Kybernetika-SPSE/DMP_Fiala/ročníkovka vol.2.kicad_pcb

## KiCad design ročníkovka vol.2.kicad_pcb (2025-01-09)

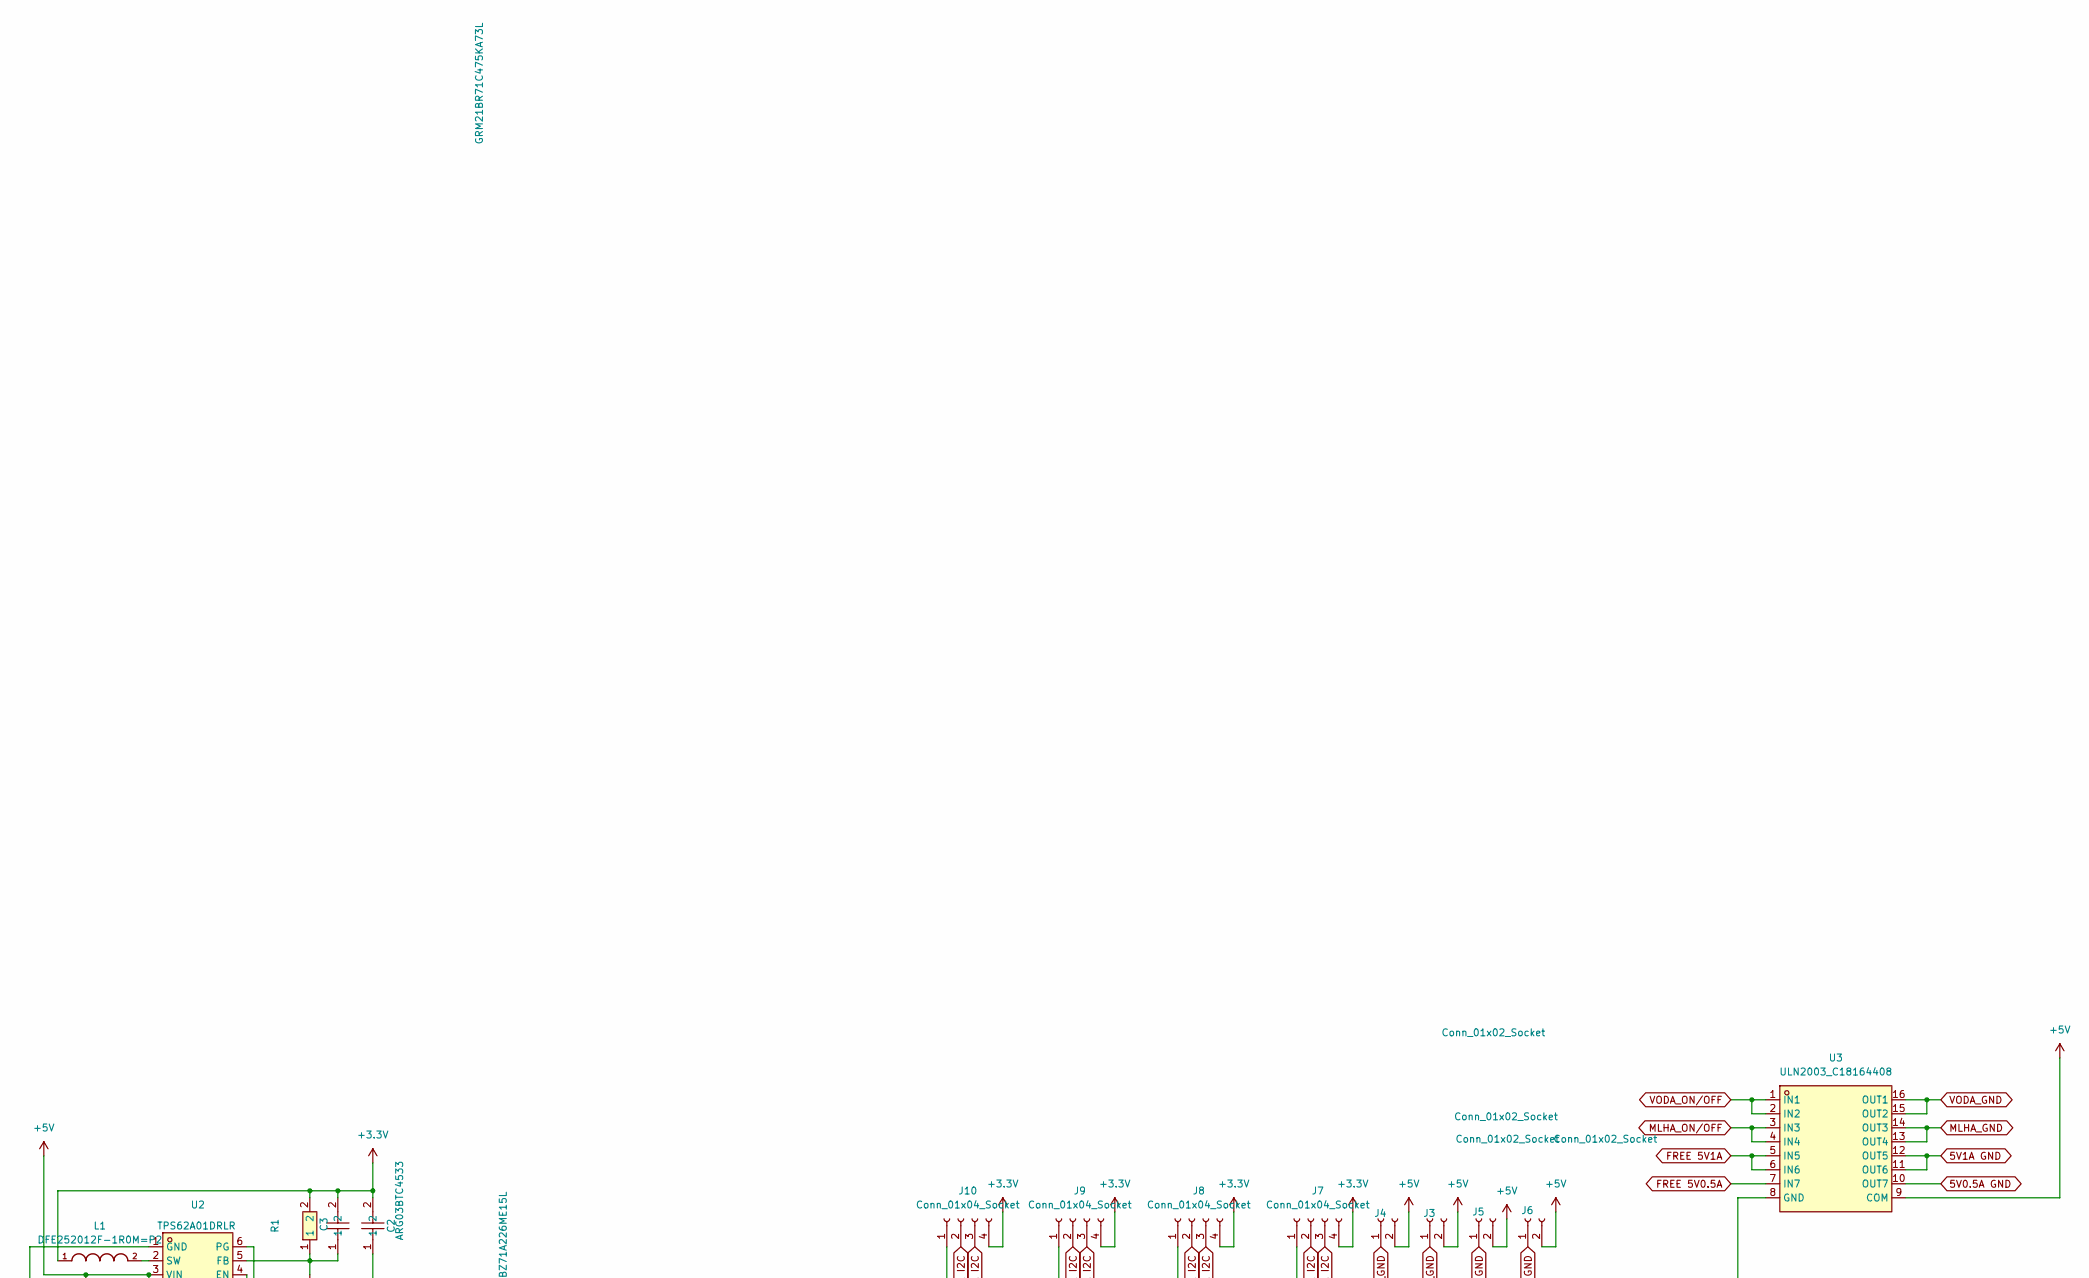
[picture p2: schematic ročníkovka vol.2.kicad_sch, part in row 1, column 1]

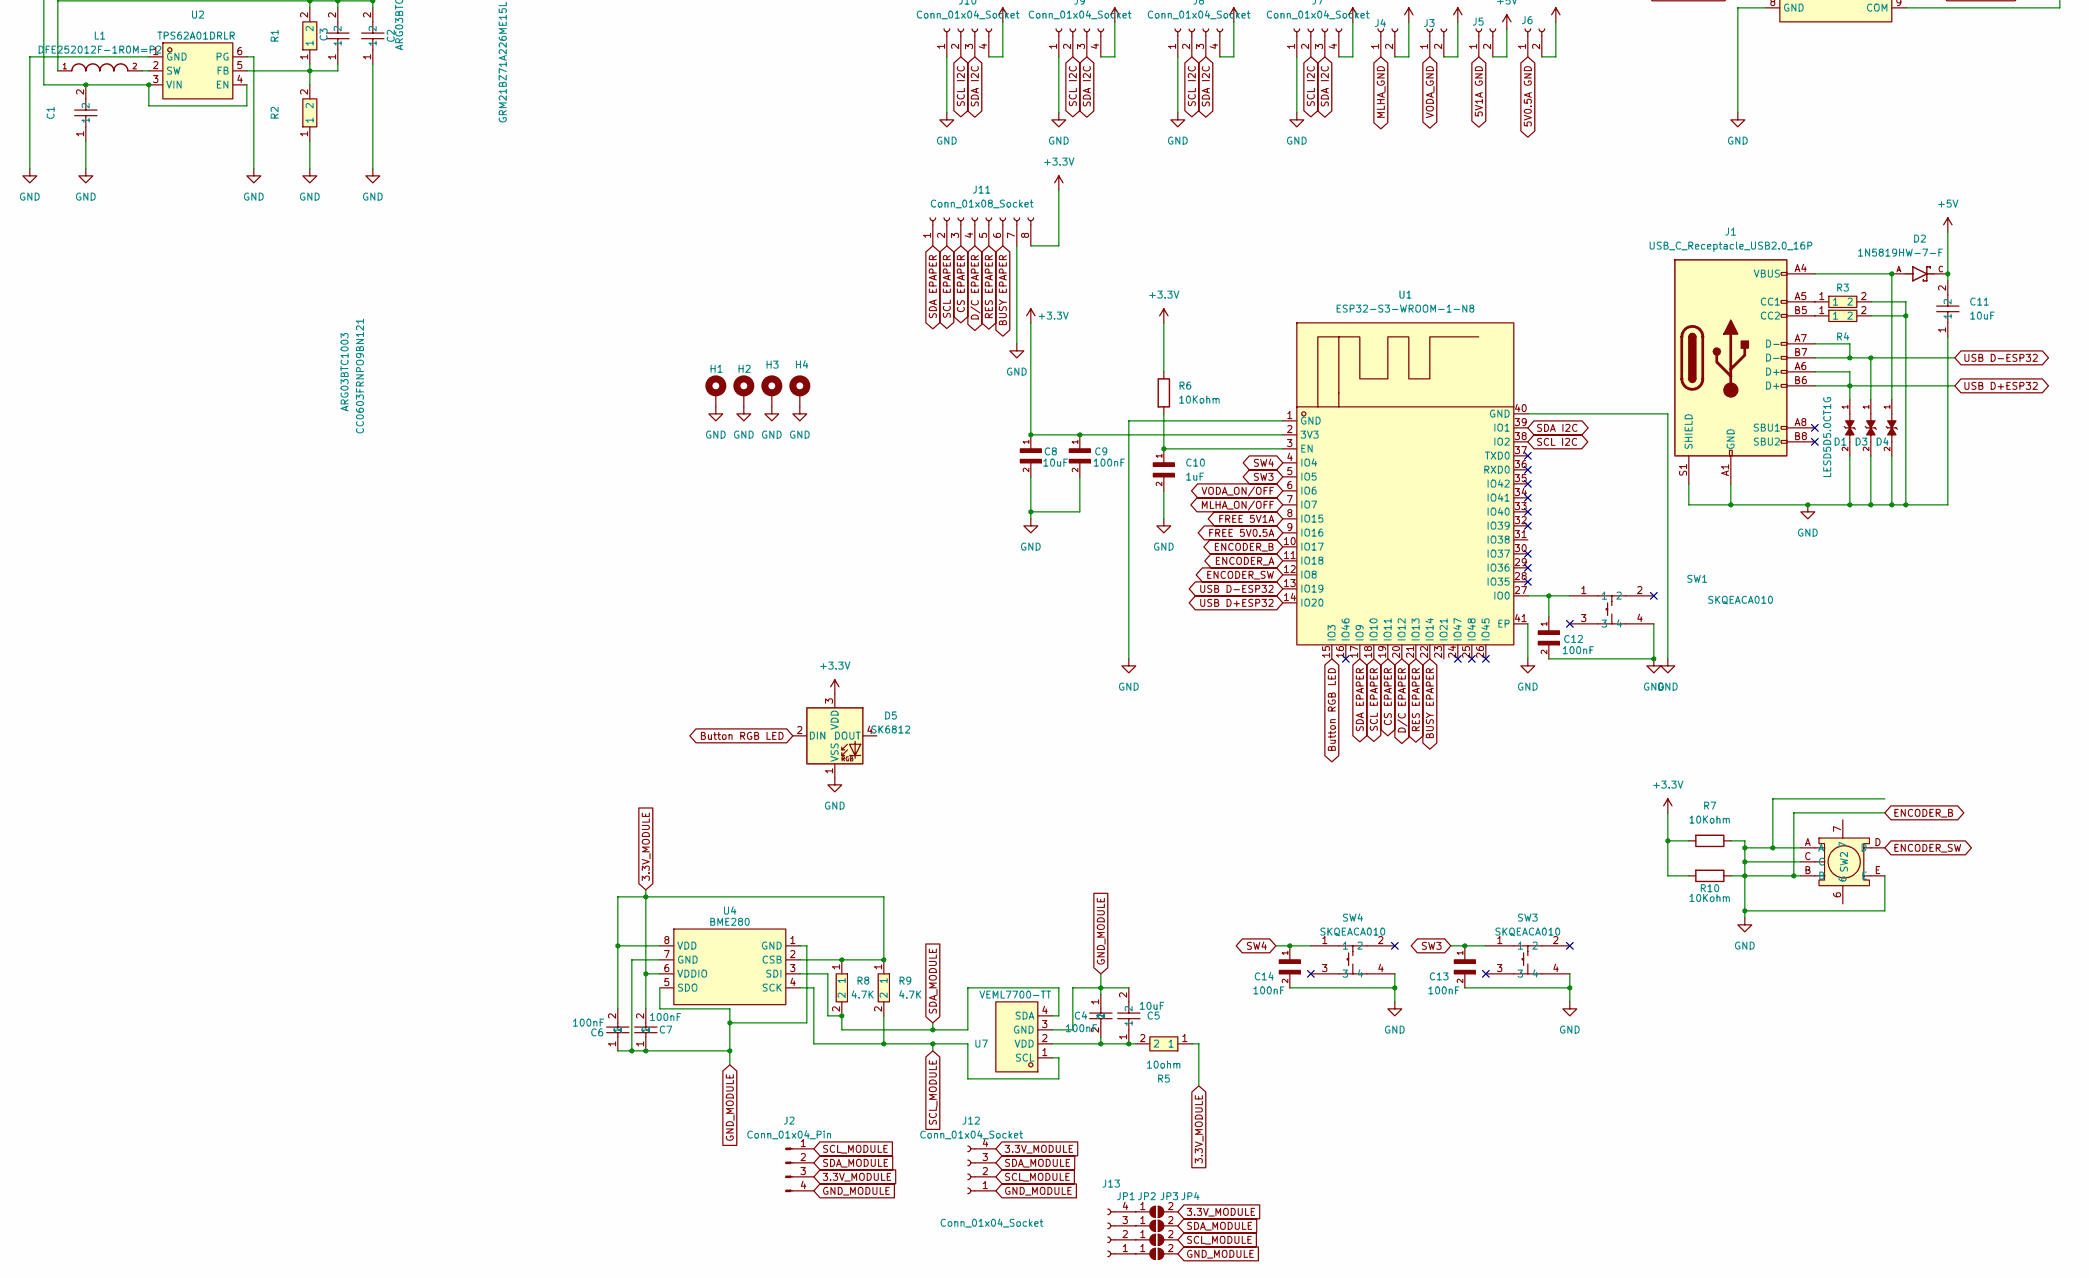
[picture p3: schematic ročníkovka vol.2.kicad_sch, part in row 2, column 1]

Parts:
C1: GRM21BR71C475KA73L; C0805; LCSC Part C86040
C2: GRM21BZ71A226ME15L; C0805; LCSC Part C907991
C3: CC0603FRNPO9BN121; C0603; LCSC Part C519498
C4, C6, C7: 100nF; C0603; LCSC Part C24452
C5: 10uF; C0603; LCSC Part C962136
C8: 10uF; CAPC1608X90N
C9, C12, C13, C14: 100nF; CAPC1608X90N
C10: 1uF; CAPC1608X90N
C11: 10uF; C0603; LCSC Part C96446
D1, D3, D4: LESD5D5.0CT1G; TVS_LESD5D5.0CT1G; PARTREV O
D2: 1N5819HW-7-F; SOD3715X145N; PARTREV 18-2
D5: SK6812; LED_SK6812_PLCC4_5.0x5.0mm_P3.2mm
H1, H2, H3, H4: MountingHole_Pad; MountingHole_3.2mm_M3_Pad_TopBottom
J1: USB_C_Receptacle_USB2.0_16P; USB_C_Receptacle_GCT_USB4105-xx-A_16P_TopMnt_Horizontal; LCSC Part C2988369
J2: Conn_01x04_Pin; JST_PH_B4B-PH-K_1x04_P2.00mm_Vertical
J3, J4, J5, J6: Conn_01x02_Socket; JST_PH_S2B-PH-K_1x02_P2.00mm_Horizontal
J7, J8, J9, J10, J12, J13: Conn_01x04_Socket; JST_PH_S4B-PH-K_1x04_P2.00mm_Horizontal
J11: Conn_01x08_Socket; JST_PH_S8B-PH-K_1x08_P2.00mm_Horizontal
JP1, JP2, JP3, JP4: SolderJumper_2_Open; SolderJumper-2_P1.3mm_Open_TrianglePad1.0x1.5mm
L1: DFE252012F-1R0M=P2; INDC2520X120N
R1: ARG03BTC4533; R0603; LCSC Part C2686428
R2: ARG03BTC1003; R0603; LCSC Part C335088
R3, R4: 0603WAF5101T5E; R0603; LCSC Part C23186
R5: 10ohm; R0603; LCSC Part C414987
R6, R7, R10: 10Kohm; RESC1608X55N
R8, R9: 4.7K; R0603; LCSC Part C99782
SW1, SW3, SW4: SKQEACA010; KEY-TH_4P-L12.0-W12.0-P5.0-LS12.5-EH; LCSC Part C107236
SW2: EC11E15244G1; SW-TH_EC11E15244G1; LCSC Part C370970
U1: ESP32-S3-WROOM-1-N8; WIFIM-SMD_ESP32-S3-WROOM-1-N8; LCSC Part C2913198
U2: TPS62A01DRLR; SOT-5X3-6_L1.6-W1.2-P0.50-LS1.6-BR; LCSC Part C5157937
U3: ULN2003_C18164408; SOP-16_L9.9-W3.9-P1.27-LS6.0-BL; LCSC Part C18164408
U4: BME280; PSON65P250X250X100-8N; LCSC Part C92489
U7: VEML7700-TT; SENSOR-SMD_EML7700-TT; LCSC Part C1850416

Connections:
3.3V_MODULE: C6.2, C7.2, J2.3, J12.4, JP1.2 (B), R5.1, R8.1, R9.1, U4.2 (CSB), U4.6 (VDDIO), U4.8 (VDD)
5V0.5A GND: J6.1, U3.10 (OUT7)
5V1A GND: J5.1, U3.11 (OUT6), U3.12 (OUT5)
+3.3V: C2.2, C3.2, C8.1, C9.1, D5.3 (VDD), J7.4, J8.4, J9.4, J10.4, J11.8, L1.1, R1.2, R6.1, R7.2, R10.2, U1.2 (3V3)
+5V: C1.2, C11.2, D2.C, J3.2, J4.2, J5.2, J6.2, U2.3 (VIN), U2.4 (EN), U3.9 (COM)
BUSY EPAPER: J11.6, U1.22 (IO14)
Button RGB LED: D5.2 (DIN), U1.15 (IO3)
CS EPAPER: J11.3, U1.19 (IO11)
D/C EPAPER: J11.4, U1.20 (IO12)
ENCODER_A: U1.11 (IO18)
ENCODER_B: C1.1, C2.1, C8.2, C9.2, C10.2, C11.1, C12.2, C13.2, C14.2, D1.2, D3.2, D4.2, D5.1 (VSS), H1.1, H2.1, H3.1, H4.1, J1.A1 (GND), J1.A12 (GND), J1.B1 (GND), J1.B12 (GND), J1.S1 (SHIELD), J7.1, J8.1, J9.1, J10.1, J11.7, R2.1, R3.2, R4.2, R7.1, R10.1, SW1.4, SW2.A, SW2.B, SW2.C, SW2.E, SW3.4, SW4.4, U1.1 (GND), U1.10 (IO17), U1.40 (GND), U1.41 (EP), U2.1 (GND), U2.6 (PG), U3.8 (GND)
ENCODER_SW: SW2.D, U1.12 (IO8)
FREE 5V0.5A: U1.9 (IO16), U3.7 (IN7)
FREE 5V1A: U1.8 (IO15), U3.5 (IN5), U3.6 (IN6)
GND_MODULE: C4.1, C5.2, C6.1, C7.1, J2.4, J12.1, JP4.2 (B), U4.1 (GND), U4.5 (SDO), U4.7 (GND), U7.3 (GND)
MLHA_GND: J4.1, U3.13 (OUT4), U3.14 (OUT3)
MLHA_ON/OFF: U1.7 (IO7), U3.3 (IN3), U3.4 (IN4)
unnamed: D2.A, D4.1, J1.A4 (VBUS), J1.A9 (VBUS), J1.B4 (VBUS), J1.B9 (VBUS)
unnamed: J1.A5 (CC1), R3.1
unnamed: J1.B5 (CC2), R4.1
unnamed: J13.1, JP4.1 (A)
unnamed: J13.2, JP3.1 (A)
unnamed: J13.3, JP2.1 (A)
unnamed: J13.4, JP1.1 (A)
unnamed: C10.1, R6.2, U1.3 (EN)
unnamed: C12.1, SW1.1, U1.27 (IO0)
unnamed: C3.1, R1.1, R2.2, U2.5 (FB)
unnamed: L1.2, U2.2 (SW)
unnamed: C4.2, C5.1, R5.2, U7.2 (VDD)
RES EPAPER: J11.5, U1.21 (IO13)
SCL EPAPER: J11.2, U1.18 (IO10)
SCL I2C: J7.2, J8.2, J9.2, J10.2, U1.38 (IO2)
SCL_MODULE: J2.1, J12.2, JP3.2 (B), R9.2, U4.4 (SCK), U7.1 (SCL)
SDA EPAPER: J11.1, U1.17 (IO9)
SDA I2C: J7.3, J8.3, J9.3, J10.3, U1.39 (IO1)
SDA_MODULE: J2.2, J12.3, JP2.2 (B), R8.2, U4.3 (SDI), U7.4 (SDA)
SW3: C13.1, SW3.1, U1.5 (IO5)
SW4: C14.1, SW4.1, U1.4 (IO4)
USB D+ESP32: D1.1, J1.A6 (D+), J1.B6 (D+), U1.14 (IO20)
USB D-ESP32: D3.1, J1.A7 (D-), J1.B7 (D-), U1.13 (IO19)
VODA_GND: J3.1, U3.15 (OUT2), U3.16 (OUT1)
VODA_ON/OFF: U1.6 (IO6), U3.1 (IN1), U3.2 (IN2)

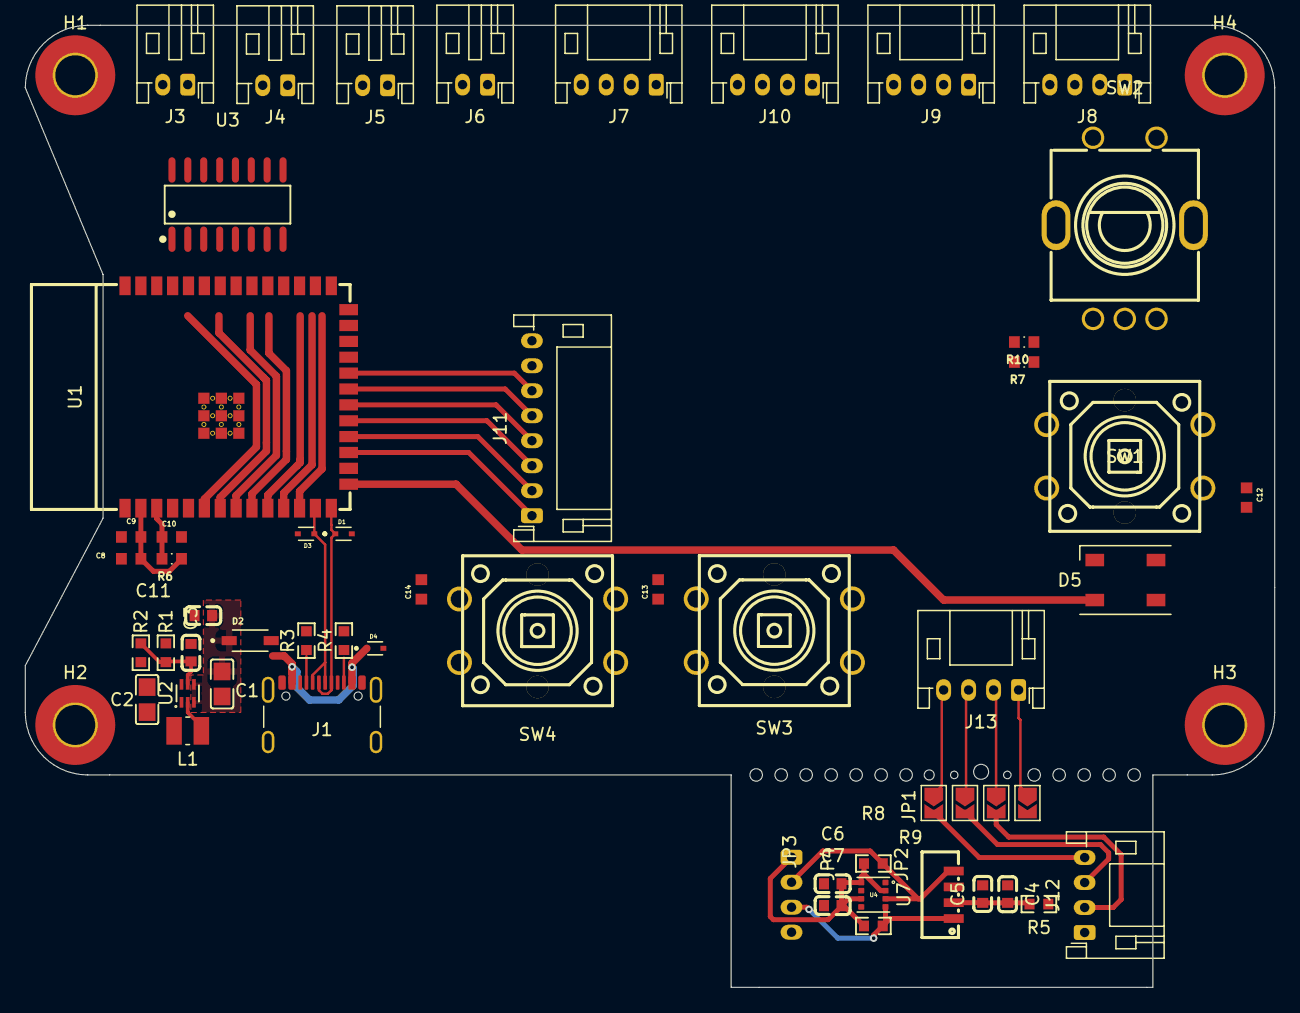
[picture p4: board ročníkovka vol.2.kicad_pcb from above]

Board: 2 copper layers, 100.0 x 77.0 mm, 60 parts (1 on the bottom side), 41 nets.
