Kybernetika-SPSE/DMP_Fiala/(threads)

Thread 1 (2025-01-09):

Problém se zkratovanými cestami, prosím pěkně opravit

VencisF, 2025-01-09:
Příklad zkratování cest, potřebuji oddělit. Dík moc

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

bublinak, 2025-01-10:
# Problem found
Máš to tady. Vyzkratoval jsi si celou zem a ten globální flag ji přejmenoval
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

Closed 2025-01-10.
